YavuzSB/Teknofest-Sancak-Hava-Savunma-Sistemi/_extra/rapor belgeleri/Dusman_hedef.png

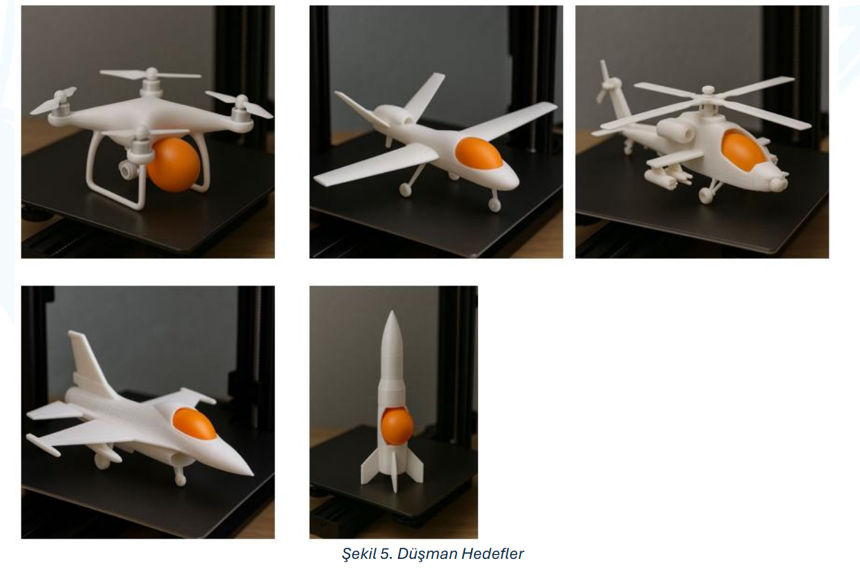
_extra/rapor belgeleri/Dusman_hedef.png
