YavuzSB/Teknofest-Sancak-Hava-Savunma-Sistemi/_extra/rapor belgeleri/Dost_hedef.png

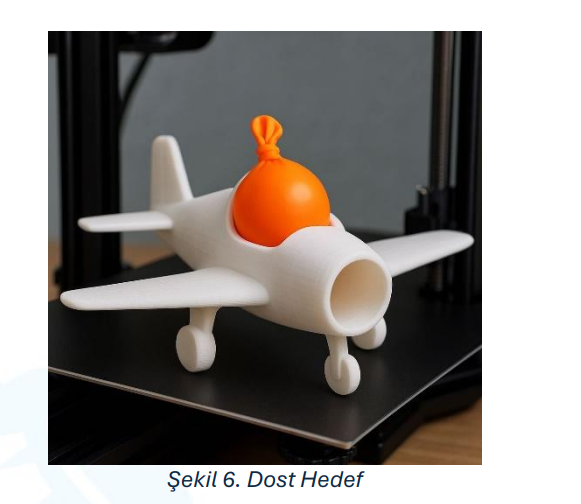
_extra/rapor belgeleri/Dost_hedef.png
