YavuzSB/Teknofest-Sancak-Hava-Savunma-Sistemi/_extra/rapor belgeleri/2025 SkyTech Ön Tasarım Raporu (ÖTR).pdf

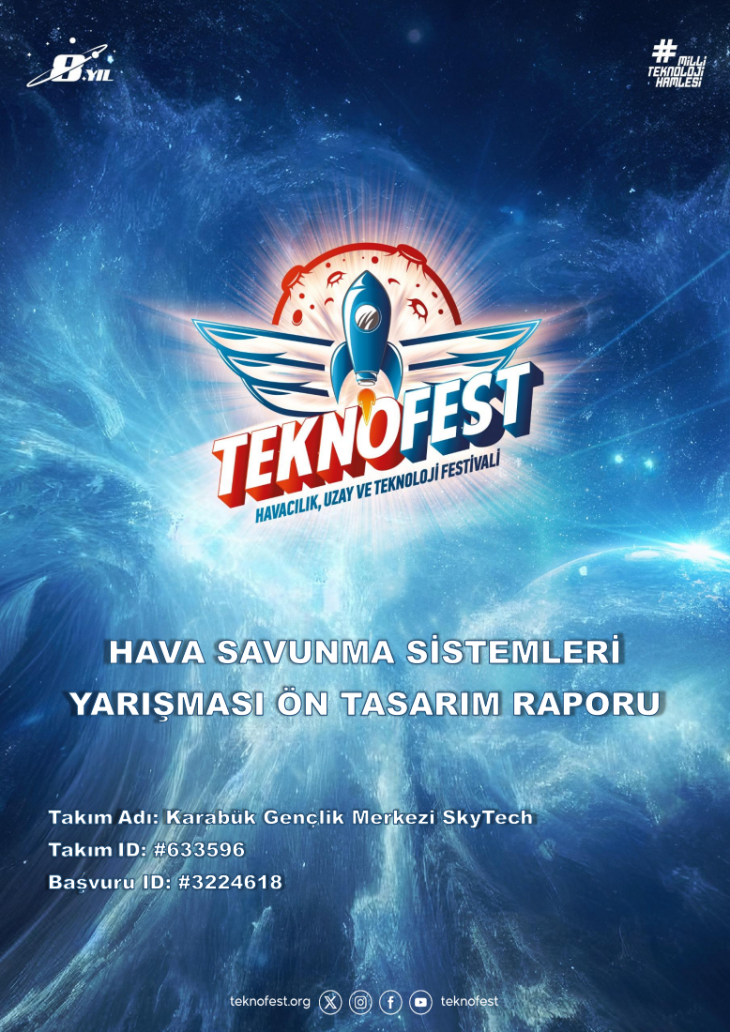
[picture p54: page 1]
“SkyTech”; Takım

HAVA SAVUNMA SİSTEMLERİ YARIŞMASI 2025

HAVA SAVUNMA SİSTEMLERİ

İÇİNDEKİLER

### 1. PROJE ÖZETİ

SkyTech takımı, Teknofest 2024’te video gönderim aşamasına kadar ilerlemiş ve 2025’te zirveyi hedefleyerek yoluna devam etmektedir. Takımın amacı, şartnameye uygun, maliyeti düşük ve verimli bir hava savunma sistemi geliştirmektir. Bu doğrultuda, mekanik ekip tasarım ve montaj, elektronik ekip donanım ve entegrasyon, yazılım ekibi ise görüntü işleme ve arayüz üzerine çalışmaktadır.

### 2. TAKIM ŞEMASI

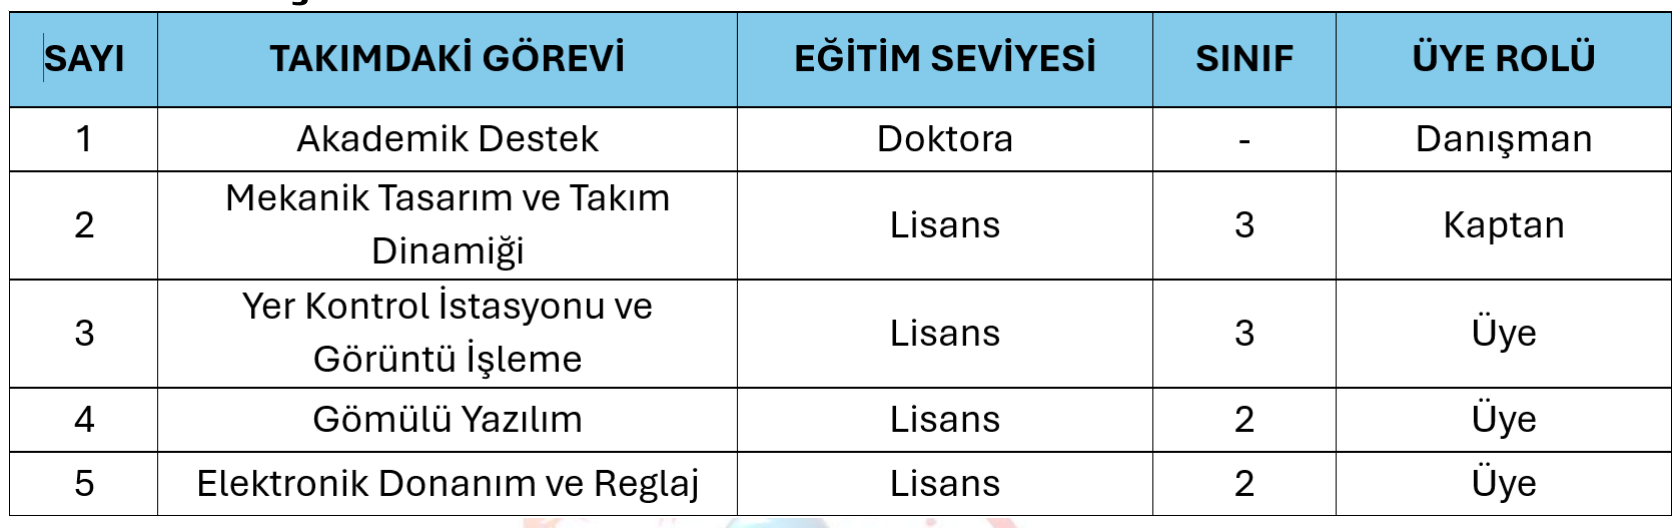
[picture p55: figure]

### 3. SİSTEM ÖN TASARIMI

### 3.1. Donanım Tasarım

### 3.1.1. Mekanik Tasarım 3.1.1.1. Mekanik Tasarım Özellikleri

Sistemin mekanik tasarımı, 55×55×58 cm ölçülerinde ve yaklaşık 15 kg ağırlığında olacaktır. Tasarım; önemli parçalara kolay erişim, hafiflik, rijitlik ve kolay montaj öncelikleriyle yapılmıştır.

### 3.1.1.2. Şase-Gövde-Kapak Bağıntısı

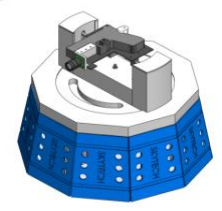
[picture p56: figure]
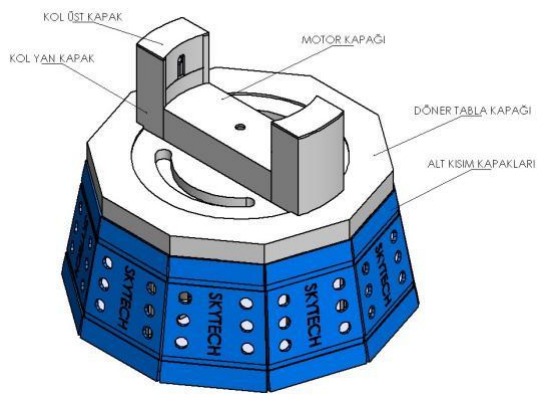
[picture p57: figure]
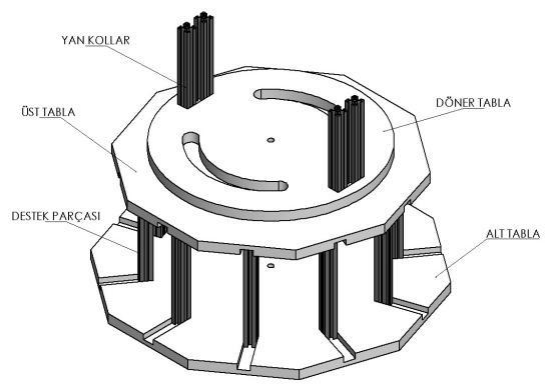
[picture p58: figure]

Sistem şasesi, lazer kesim sunta ve 20x20 alüminyum sigma profillerden oluşur. Kapaklar PLA ile 3D yazıcıda üretilip vidalarla sabitlenir. Bu malzemeler dayanıklı, ucuz ve kolay işlenebilir olarak seçilmiştir.

### 3.1.1.3. Hareket Mekanizmaları

Sistem, yatay ve dikey dönme için iki motor ve kayış-kasnak sistemi kullanır. Dikey hareket, 27kg/cm tork ve 150 rpm hızındaki DC motorla sağlanır. Kayış-kasnak sistemi, torku arttırarak motoru zorlamaz. 8mm krom indüksiyon mili, mil tutucu ve rulmanla yerleştirilmiştir. 25cm GT2 kayış, uygun mesafeye göre seçilmiştir. Yatay dönme de aynı prensiple çalışır.

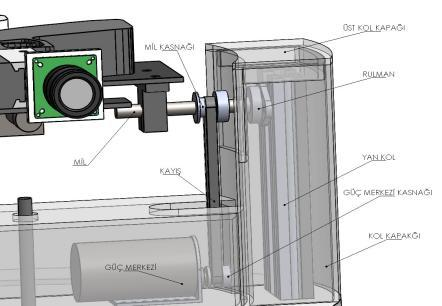
[picture p59: figure]

### 3.1.1.4. Silah Mekanizması

Silah montaj mekanizması; silahlık tablası, PLA kamera sabitleyici ve sabitleme kızağından oluşur. Tabla sağlam olması için lazer kesim ile kesilecek alüminyumdan üretilecektir. Sabitleme kızağı, silahın ön eklenti kızağına uyumlu olup, sıkı geçme sağlar. Arka sıkıştırma aparatı silahı sabitler. Mil tutucu tablayı tutmak için, çekme selenoidi ise tetiği çekmek için kullanılır. Silah,

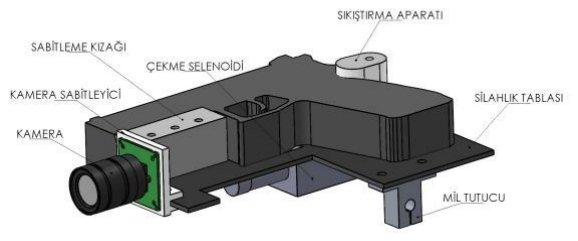
[picture p60: figure]

tepme kuvvetini en aza indirmek için yan konumlandırılmıştır. Silah olarak airsoft silahı CZP-09 kullanılacaktır.

### 3.1.2. Elektronik Tasarım

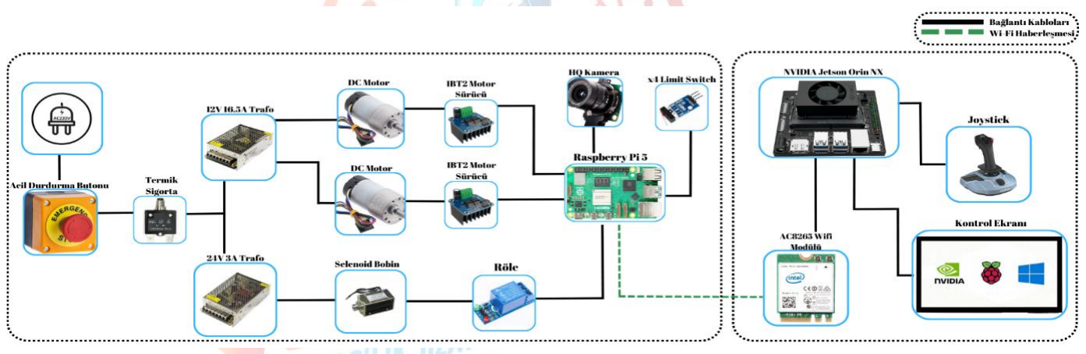
[picture p61: figure]

Elektronik tasarım kontrol istasyonu ve sistem olarak iki ana kısımdan oluşur. Sistemde, eksen hareketlerini sağlayan DC motorlar, motor sürücüler, limit switchler, kamera ve röle kontrollü selenoid bobin, Raspberry Pi 5’e bağlanarak çalıştırılır. Raspberry Pi 5, Wi-Fi ile kontrol istasyonuna bağlanarak sistemin kontrolünü sağlar. Kontrol istasyonu, görüntü işleme ve kullanıcı komutları için Jetson Orin NX, joystick ve monitörden oluşur. Güç beslemesi, yarışma alanındaki 220VAC’nin acil durdurma butonu ve termik sigorta üzerinden trafolar ve adaptörlere bağlanmasıyla sağlanır.

### 3.2. Yazılım Tasarım

### 3.2.1 Atış Kontrol Algoritması

Atış kontrol algoritması, önce sistemin hedefe kilitlenmesinden emin olup, ardından tetiği çalıştırarak hedefin imha edilmesini sağlar.

### 3.2.2. Görüntü İşleme ve Görev Algoritmaları

Görüntü işleme yazılımı YOLO algoritması kullanılarak yapılacak olup, kamera verileri arayüze geldikten sonra seçilen görev algoritması çalışacaktır.

### 3.2.2.1. Hareketli Hedef İmhası

Algoritma, takip emri aldıktan sonra tespit edilen balonlara ID atar. En küçük ID’den başlayarak hedefin orta noktasını hesaplar ve o noktaya göre takibe başlar. Daha sonra atış emri beklenir, emir geldikten sonra atış kontrol algoritması devreye girerek hedef imha edilir.

### 3.2.2.2. Hareketli Dost/Düşman Hedef Ayrımı ve İmhası

Algoritma otonom çalışarak hedefleri renklerine göre dost-düşman olarak tespit eder ve düşman hedeflerin orta noktasını hesaplayarak o noktaya göre takibe başlar. Ardından atış kontrol algoritması devreye girerek hedef imha edilir.

### 3.2.2.3. Angajman Cisim ile Hedef İmhası

Algoritma, önce angajman nesne ve hedef tahtası bilgilerini alır. Daha sonra hedef tahtasına yönelip hedefi tespit eder. Ardından hedefin orta noktasını hesaplayarak o noktaya göre takibe başlar. Atış kontrol algoritmasıyla birlikte hedef imha edilir.

### 3.2.3. Kullanıcı Arayüzü

Kontrol istasyonunun kullanıcı arayüzünde her görev için bir pencere ve genel görev
menüsü | ile | toplam | 4 | pencere
bulunmaktadır. | Her | pencere, | araçtaki
kameradan gelen görüntülerin analizini ve görevle ilgili emirleri içerir. Tüm pencereler,
atışa | yasaklı | alan | tanımlama | emrini
kullanıcıdan alabilir. Kullanıcı arayüzünün yapımı ve geliştirilmesi devam etmektedir.

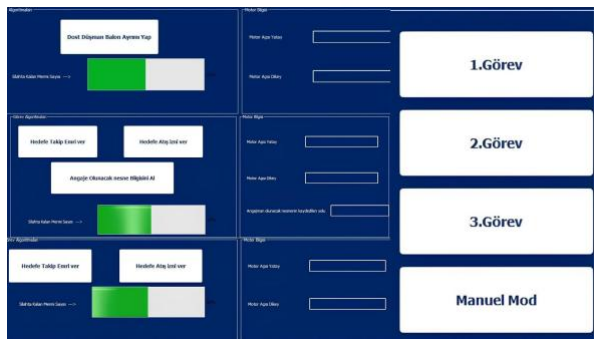
[picture p62: figure]

### 3.3. Malzeme Listesi

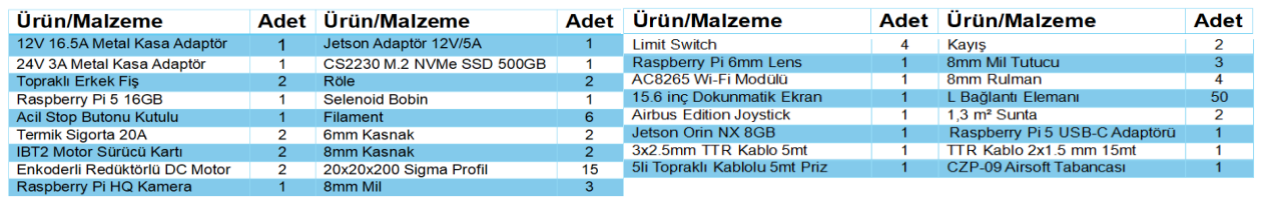
[picture p63: figure]

### 4. YÖNTEM

Projede, hava savunma sisteminin görevlerini etkili ve verimli şekilde
yerine | getirebilmesi | için | seçilen
yöntem, her aşamada doğruluğu
maksimize | edecek | şekilde
tasarlanmıştır. | Hedef | tespiti | için
YOLO algoritması tercih edilmiştir çünkü hızlı ve doğru hedef tanıma sağlarken, diğer algoritmalara kıyasla daha düşük işlem süresi sağlar. Takımımız Teknofest 2024’te step

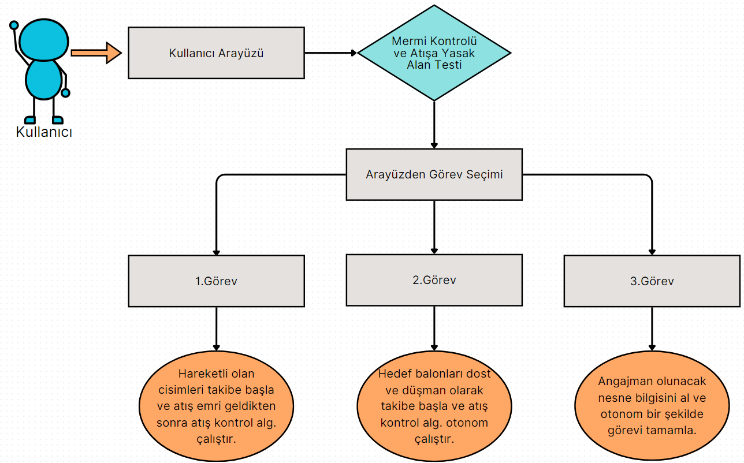
[picture p64: figure]

motor ve sistemi motor miline bağlama yöntemi kullanılmıştır. Bu mekanik tasarımımızda ise DC motora geçilme sebebi step motora göre tork kaybı olmadan daha fazla dönüş açısı elde edebilmektir. Kayış kasnak kullanılma sebebi ise motor milini sisteme bağlama yöntemine göre daha fazla rijitlik sağlamak ve torku daha da arttırmaktır. Sistemde kullanılan Raspberry Pi 5 ve Jetson Orin'in kartları, sistemin performans gereksinimine göre görüntü işleme ve kontrol süreçleri için seçilmiştir.

### 5. ZAMAN VE BÜTÇE PLANLAMASI

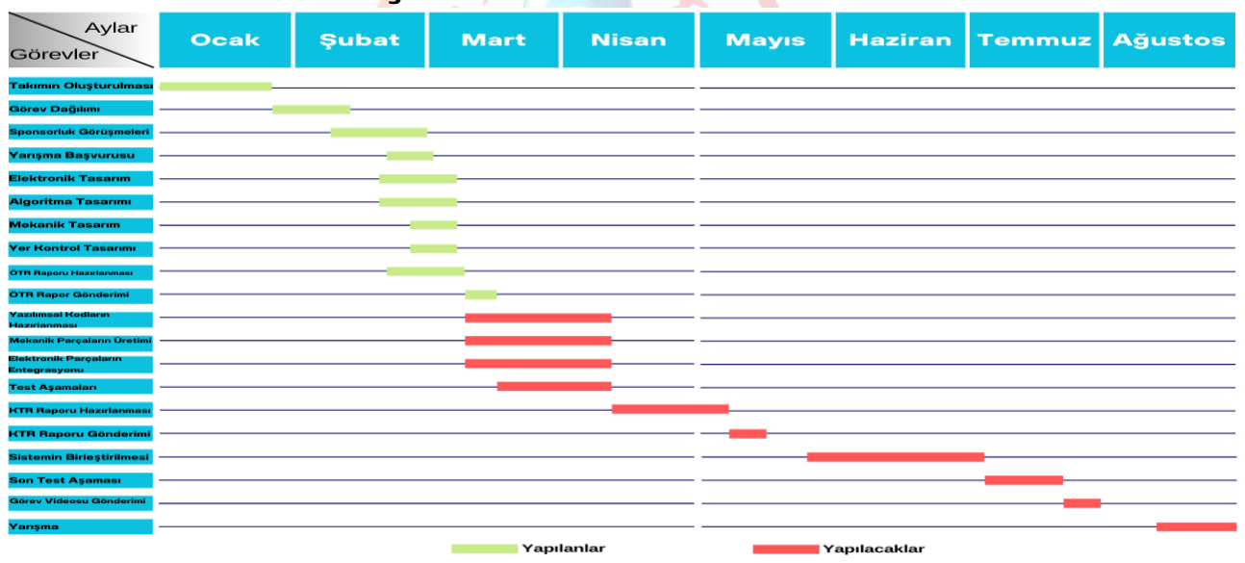
[picture p65: figure]

Zaman takibini kolaylaştırmak için görevler aylara bölünmüştür. Bütçe ise bölüm 3.3’te bahsedilen malzemelere göre mekanik ve elektronik olarak 2’ye ayrılmıştır.

### 6. KAYNAKÇA

[1] Dersi, F., “Eylemsizlik momenti nedir?” https://fizikdersi.gen.tr/eylemsizlik-momenti-nedir/
[2] ultralytics.com “Oriented Bounding Boxes Object Detection” https://docs.ultralytics.com/tasks/obb/
[3] ystendustri.com “DC MOTOR NEDİR ? NERELERDE KULLANILIR ?” https://www.ystendustri.com/blogyazisi/dc-motor-nedir-nerelerde-kullanilir
Ürün/Malzeme | Bütçe | Ürün/Malzeme | Bütçe
MEKANİK | 14.483,31 | ELEKTRONİK | 67.683,76
