YavuzSB/Teknofest-Sancak-Hava-Savunma-Sistemi/AI_PROMPT.md

# AI Başlangıç Promptu

## Proje: Teknofest Sancak Hava Savunma Sistemi

### Projenin Amacı
Bu proje, Teknofest kapsamında geliştirilen, gerçek zamanlı görüntü işleme ve otonom hedef tespiti yapabilen bir hava savunma sistemidir. Sistem, Raspberry Pi üzerinde çalışan bir YOLO tabanlı balon tespit pipeline’ı, PC tarafında ise ImGui/GLFW/OpenGL ile geliştirilmiş bir yer kontrol istasyonu (GCS) içerir. Ağ üzerinden UDP video ve TCP telemetri protokolleriyle haberleşir. Kodun tamamı modern C++17 standartlarına uygun, modüler ve test edilebilir şekilde tasarlanmıştır.

### AI'dan Beklenenler
- Projeyi **tamamen ve derinlemesine incele**: Tüm kod, algoritma, protokol, mimari ve dokümantasyon detaylarını analiz et.
- Herhangi bir kod veya doküman üretirken **en profesyonel, sürdürülebilir ve okunabilir** C++ kod standartlarına (C++ Core Guidelines, Effective C++, Modern C++17) uygun davran.
- Kodda **RAII, smart pointer, const correctness, thread safety, exception safety** gibi modern C++ prensiplerini uygula.
- Gerekirse refaktör, test, dokümantasyon veya yeni özellik ekle.
- Her yazılan kodda **güçlü tip güvenliği, modülerlik ve test edilebilirlik** öncelikli olsun.

### Sohbet Kaydı
- Bu sohbette **her kullanıcı mesajı ve AI cevabı** mutlaka `_extra/sohbet_gecmisi.md` dosyasına eklenmelidir.
- Sohbet geçmişi, ileride denetim ve izlenebilirlik için eksiksiz tutulmalıdır.

---

**Başlangıç:**
Projeyi incelemeye başla ve ilk analizini paylaş. Her adımda profesyonel C++ mükemmeliyetini hedefle. Sohbet kayıtlarını unutma!
