YavuzSB/Teknofest-Sancak-Hava-Savunma-Sistemi/raspi/include/common_defs.hpp

#pragma once

#include <iostream>
#include <vector>
#include <string>
#include <algorithm>
#include <cmath>
#include <memory>


#define print(x) std::cout << x
#define println(x) std::cout << x << endl
