YavuzSB/Teknofest-Sancak-Hava-Savunma-Sistemi/(commit log)

2026-02-24 core: platform build fix, trigger/IFF/lost-target safety, watchdog refactor
    - CMake: Windows ortamında raspi/alt projesi ve OpenCV bağımlılığı opsiyonel yapıldı, PC hedefi default açık (SANCAK_BUILD_PC/BUILD_RASPI)
    - Presetler güncellendi: Windows’ta sadece PC derlenir, Linux/Raspi’de raspi hedefi default açık
    - TriggerController: FPS bağımsız, zaman bazlı lock (lock_duration_ms)
    - IFF: majority voting + hysteresis ile kararlı kimlik
    - Lost target: kadrajdan çıkan hedefe ateş kesinlikle kesiliyor (state machine)
    - Watchdog: kamera donma fail-safe akışı finalize ile güvenli, derleme kıran çağrı kaldırıldı
    - Test: TriggerController birim testi zaman bazlı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
    [combat_pipeline.cpp, combat_pipeline.hpp, config_manager.cpp, config_manager.hpp, sancak_config.yml, target_tracker.cpp]
2026-03-01 Lidar entegrasyonu: MockLidar, thread-safe cache, pipeline fusion, offset ve config desteği
2026-03-01 UART binary protokol: ProtocolDef + CRC16 + PacketBuilder + Arduino RX örneği
2026-03-01 serial.protocol ile ASCII/Binary UART seçimi
